pigatron-industries/xen_sequentialswitch/hardware/PGTN029_sequential_switch.brd

## EAGLE design hardware/PGTN029_sequential_switch.brd (2021-08-22)

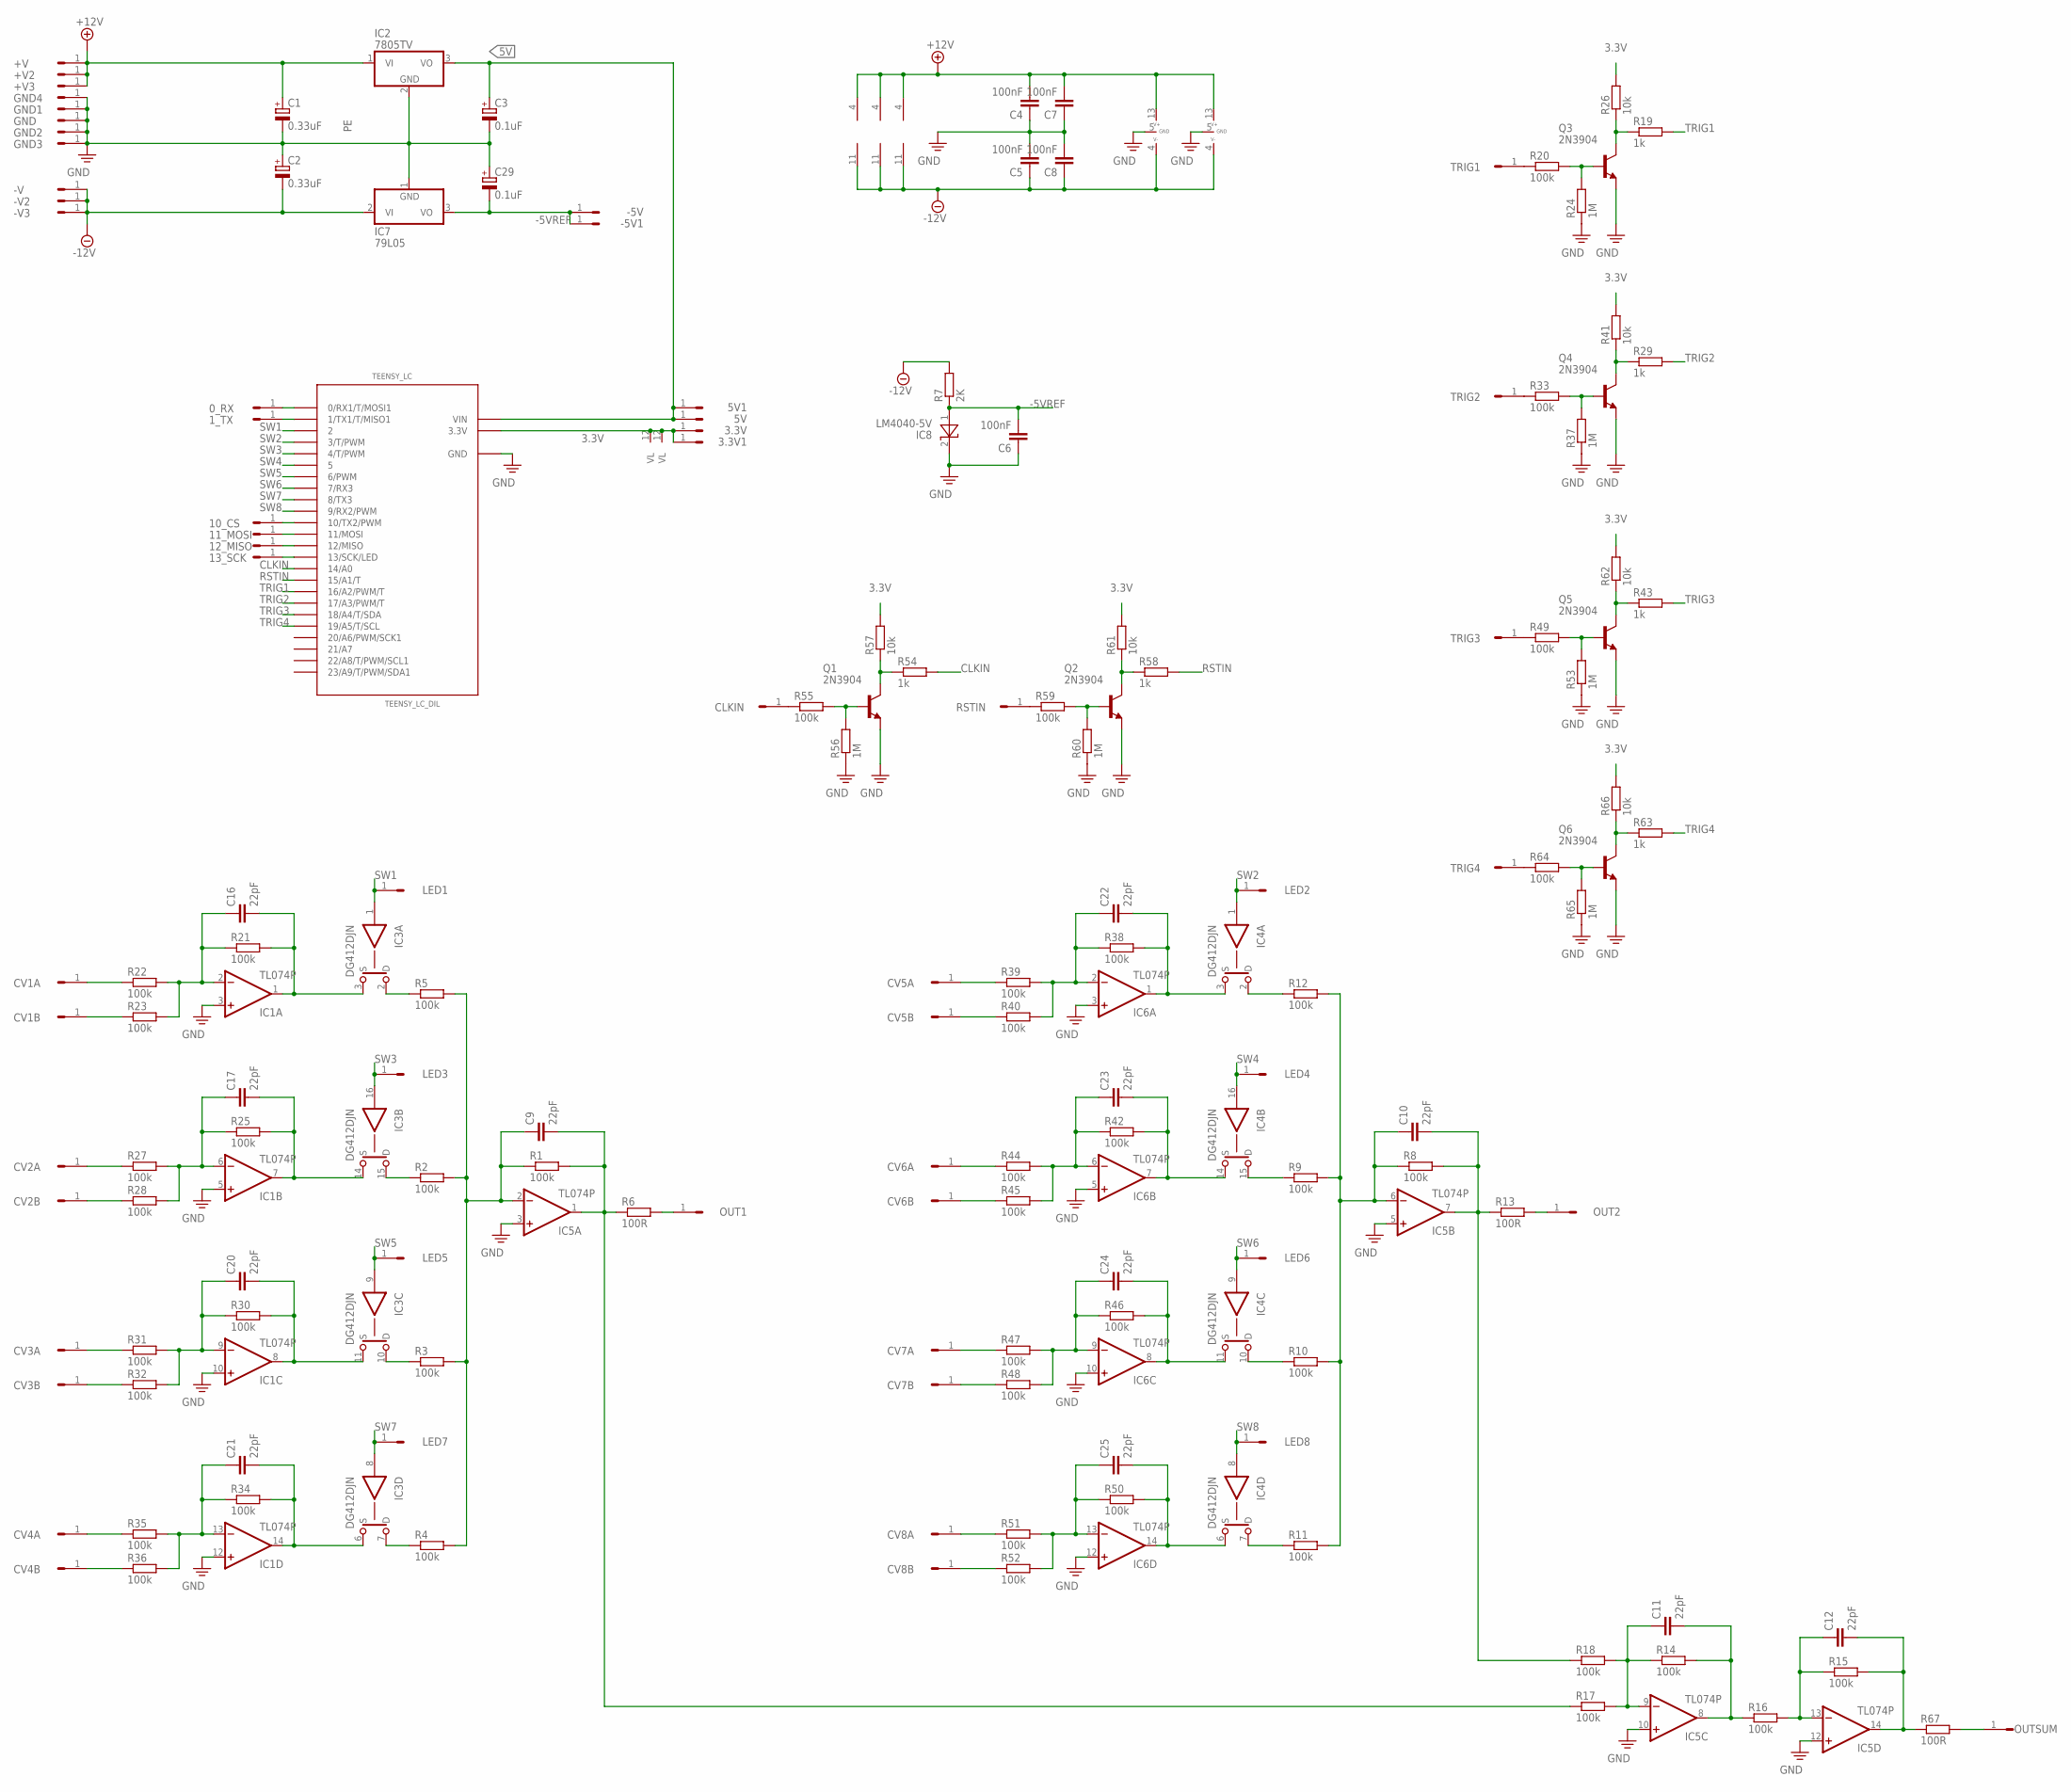
[picture p1: schematic PGTN029_sequential_switch.sch]

Parts:
0_RX, 1_TX, 3.3V, 3.3V1, 5V, 5V1, 10_CS, 11_MOSI, 12_MISO, 13_SCK: HEADER/MALE/01
+V, +V2, +V3: HEADER/MALE/01
-5V, -5V1: HEADER/MALE/01
-V, -V2, -V3: HEADER/MALE/01
C1, C2: 0.33uF; E2,5-6
C3, C29: 0.1uF; E2,5-6
C4, C5, C6, C7, C8: 100nF; CERAMICDISC/5
C9, C10, C11, C12, C16, C17, C20, C21, C22, C23, C24, C25: 22pF; CERAMICDISC/5
CLKIN: HEADER/MALE/01
CV1A, CV1B, CV2A, CV2B, CV3A, CV3B, CV4A, CV4B, CV5A, CV5B, CV6A, CV6B, CV7A, CV7B, CV8A, CV8B: HEADER/MALE/01
GND, GND1, GND2, GND3, GND4: HEADER/MALE/01
IC1, IC5, IC6: TL074P; DIL14
IC2: 7805TV; TO220V
IC3, IC4: DG412DJN; DIL16
IC7: 79L05; TO92
IC8: LM4040-5V; TO92
LED1, LED2, LED3, LED4, LED5, LED6, LED7, LED8: HEADER/MALE/01
OUT1, OUT2: HEADER/MALE/01
OUTSUM: HEADER/MALE/01
Q1, Q2, Q3, Q4, Q5, Q6: 2N3904; TO92
R1, R2, R3, R4, R5, R8, R9, R10, R11, R12, R14, R15, R16, R17, R18, R20, R21, R22, R23, R25, R27, R28, R30, R31, R32, R33, R34, R35, R36, R38, R39, R40, R42, R44, R45, R46, R47, R48, R49, R50, R51, R52, R55, R59, R64: 100k; RESISTOR/7.5
R6, R13, R67: 100R; RESISTOR/7.5
R7: 2K; RESISTOR/7.5
R19, R29, R43, R54, R58, R63: 1k; RESISTOR/7.5
R24, R37, R53, R56, R60, R65: 1M; RESISTOR/7.5
R26, R41, R57, R61, R62, R66: 10k; RESISTOR/7.5
RSTIN: HEADER/MALE/01
TEENSY_LC: TEENSY_LC_DIL; TEENSY_3.0-3.2&LC_DIL
TRIG1, TRIG2, TRIG3, TRIG4: HEADER/MALE/01

Connections:
3.3V: 3.3V.1, 3.3V1.1, IC3.12 (VL), IC4.12 (VL), R26.2, R41.2, R57.2, R61.2, R62.2, R66.2, TEENSY_LC.3.3V
5V: 5V.1, 5V1.1, C3.+, IC2.3 (VO), TEENSY_LC.VIN
+12V: +V.1, +V2.1, +V3.1, C1.+, C4.2, C7.2, IC1.4 (V+), IC2.1 (VI), IC3.13 (V+), IC4.13 (V+), IC5.4 (V+), IC6.4 (V+)
-5VREF: -5V.1, -5V1.1, C6.2, C29.-, IC7.3 (VO), IC8.1 (A), R7.1
-12V: -V.1, -V2.1, -V3.1, C2.-, C5.1, C8.1, IC1.11 (V-), IC3.4 (V-), IC4.4 (V-), IC5.11 (V-), IC6.11 (V-), IC7.2 (VI), R7.2
ADC0: C16.2, IC1.1 (OUT), IC3.3 (S), R21.2
ADC1: C17.2, IC1.7 (OUT), IC3.14 (S), R25.2
ADC2: C20.2, IC1.8 (OUT), IC3.11 (S), R30.2
ADC3: C21.2, IC1.14 (OUT), IC3.6 (S), R34.2
ADC4: C22.2, IC4.3 (S), IC6.1 (OUT), R38.2
ADC5: C23.2, IC4.14 (S), IC6.7 (OUT), R42.2
ADC6: C24.2, IC4.11 (S), IC6.8 (OUT), R46.2
ADC7: C25.2, IC4.6 (S), IC6.14 (OUT), R50.2
CLKIN: R54.2, TEENSY_LC.14/A0
unnamed: CV2A.1, R27.1
unnamed: C9.1, IC5.2 (-IN), R1.1, R2.2, R3.2, R4.2, R5.2
unnamed: C9.2, IC5.1 (OUT), R1.2, R6.1, R17.1
unnamed: IC3.15 (D), R2.1
unnamed: IC3.2 (D), R5.1
unnamed: IC3.10 (D), R3.1
unnamed: IC3.7 (D), R4.1
unnamed: C10.1, IC5.6 (-IN), R8.1, R9.2, R10.2, R11.2, R12.2
unnamed: C10.2, IC5.7 (OUT), R8.2, R13.1, R18.1
unnamed: IC4.15 (D), R9.1
unnamed: IC4.2 (D), R12.1
unnamed: IC4.10 (D), R10.1
unnamed: IC4.7 (D), R11.1
unnamed: OUT1.1, R6.2
unnamed: OUT2.1, R13.2
unnamed: C11.2, IC5.8 (OUT), R14.2, R16.1
unnamed: C11.1, IC5.9 (-IN), R14.1, R17.2, R18.2
unnamed: C12.2, IC5.14 (OUT), R15.2, R67.1
unnamed: C12.1, IC5.13 (-IN), R15.1, R16.2
unnamed: R20.1, TRIG1.1
unnamed: Q3.2 (B), R20.2, R24.2
unnamed: CV1A.1, R22.1
unnamed: Q3.1 (C), R19.1, R26.1
unnamed: C16.1, IC1.2 (-IN), R21.1, R22.2, R23.2
unnamed: R59.1, RSTIN.1
unnamed: CV2B.1, R28.1
unnamed: CV1B.1, R23.1
unnamed: OUTSUM.1, R67.2
unnamed: C17.1, IC1.6 (-IN), R25.1, R27.2, R28.2
unnamed: C21.1, IC1.13 (-IN), R34.1, R35.2, R36.2
unnamed: CV4A.1, R35.1
unnamed: CV4B.1, R36.1
unnamed: R33.1, TRIG2.1
unnamed: CV3B.1, R32.1
unnamed: CV3A.1, R31.1
unnamed: C20.1, IC1.9 (-IN), R30.1, R31.2, R32.2
unnamed: 12_MISO.1, TEENSY_LC.12 (12/MISO)
unnamed: C22.1, IC6.2 (-IN), R38.1, R39.2, R40.2
unnamed: 0_RX.1, TEENSY_LC.0 (0/RX1/T/MOSI1)
unnamed: CV5B.1, R40.1
unnamed: CV5A.1, R39.1
unnamed: 1_TX.1, TEENSY_LC.1 (1/TX1/T/MISO1)
unnamed: C23.1, IC6.6 (-IN), R42.1, R44.2, R45.2
unnamed: CV6A.1, R44.1
unnamed: CV6B.1, R45.1
unnamed: C25.1, IC6.13 (-IN), R50.1, R51.2, R52.2
unnamed: Q4.2 (B), R33.2, R37.2
unnamed: CV8A.1, R51.1
unnamed: CV8B.1, R52.1
unnamed: CV7B.1, R48.1
unnamed: CV7A.1, R47.1
unnamed: C24.1, IC6.9 (-IN), R46.1, R47.2, R48.2
unnamed: Q4.1 (C), R29.1, R41.1
unnamed: CLKIN.1, R55.1
unnamed: Q1.2 (B), R55.2, R56.2
unnamed: Q1.1 (C), R54.1, R57.1
unnamed: Q2.2 (B), R59.2, R60.2
unnamed: Q2.1 (C), R58.1, R61.1
unnamed: R49.1, TRIG3.1
unnamed: Q5.2 (B), R49.2, R53.2
unnamed: 10_CS.1, TEENSY_LC.10 (10/TX2/PWM)
unnamed: 11_MOSI.1, TEENSY_LC.11 (11/MOSI)
unnamed: 13_SCK.1, TEENSY_LC.13 (13/SCK/LED)
unnamed: Q5.1 (C), R43.1, R62.1
unnamed: R64.1, TRIG4.1
unnamed: Q6.2 (B), R64.2, R65.2
unnamed: Q6.1 (C), R63.1, R66.1
PE: C1.-, C2.+, C3.-, C4.1, C5.2, C6.1, C7.1, C8.2, C29.+, GND.1, GND1.1, GND2.1, GND3.1, GND4.1, IC1.3 (+IN), IC1.5 (+IN), IC1.10 (+IN), IC1.12 (+IN), IC2.2 (GND), IC3.5 (GND), IC4.5 (GND), IC5.3 (+IN), IC5.5 (+IN), IC5.10 (+IN), IC5.12 (+IN), IC6.3 (+IN), IC6.5 (+IN), IC6.10 (+IN), IC6.12 (+IN), IC7.1 (GND), IC8.2 (C), Q1.3 (E), Q2.3 (E), Q3.3 (E), Q4.3 (E), Q5.3 (E), Q6.3 (E), R24.1, R37.1, R53.1, R56.1, R60.1, R65.1, TEENSY_LC.AGND (GND), TEENSY_LC.GND
RSTIN: R58.2, TEENSY_LC.15/A1 (15/A1/T)
SW1: IC3.1 (IN), LED1.1, TEENSY_LC.2
SW2: IC4.1 (IN), LED2.1, TEENSY_LC.3 (3/T/PWM)
SW3: IC3.16 (IN), LED3.1, TEENSY_LC.4 (4/T/PWM)
SW4: IC4.16 (IN), LED4.1, TEENSY_LC.5
SW5: IC3.9 (IN), LED5.1, TEENSY_LC.6 (6/PWM)
SW6: IC4.9 (IN), LED6.1, TEENSY_LC.7 (7/RX3)
SW7: IC3.8 (IN), LED7.1, TEENSY_LC.8 (8/TX3)
SW8: IC4.8 (IN), LED8.1, TEENSY_LC.9 (9/RX2/PWM)
TRIG1: R19.2, TEENSY_LC.16/A2 (16/A2/PWM/T)
TRIG2: R29.2, TEENSY_LC.17/A3 (17/A3/PWM/T)
TRIG3: R43.2, TEENSY_LC.18/A4 (18/A4/T/SDA)
TRIG4: R63.2, TEENSY_LC.19/A5 (19/A5/T/SCL)

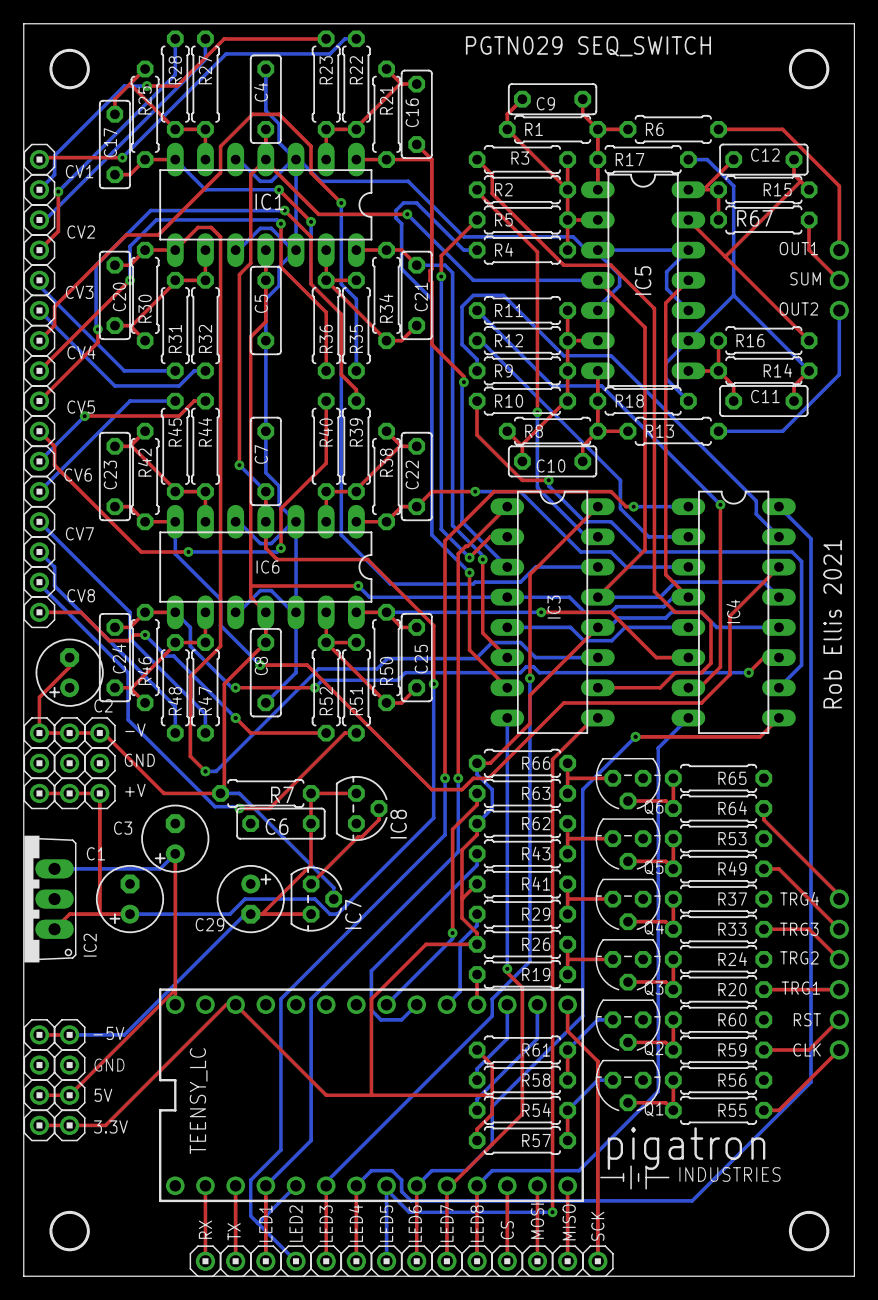
[picture p2: board PGTN029_sequential_switch.brd from above]

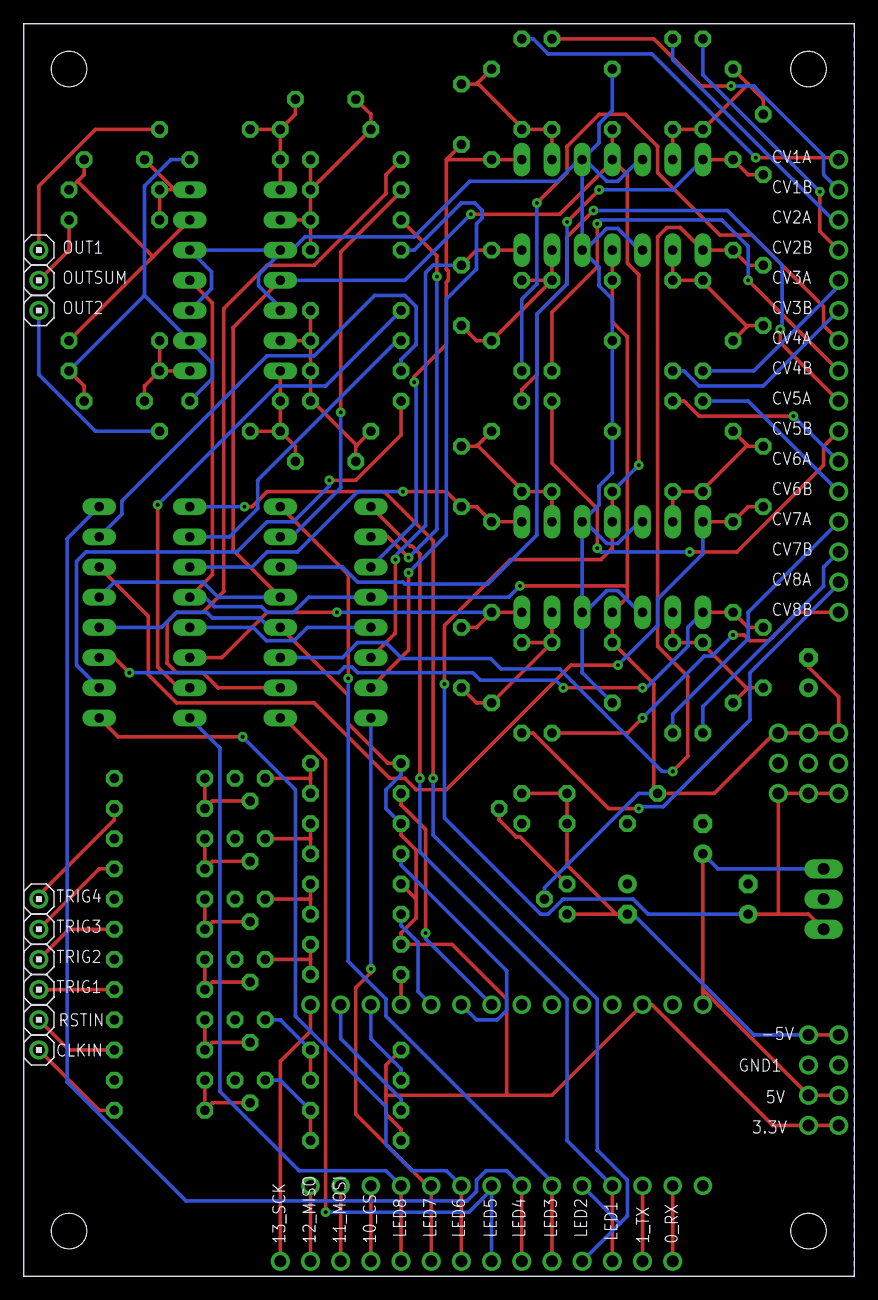
[picture p3: board PGTN029_sequential_switch.brd from below]

Board: 2 copper layers, 69.9 x 105.4 mm, 164 parts (9 on the bottom side), 95 nets.

Other parts of the board:
U$2, U$3, U$4, U$7: STANDOFF/3.0
U$5: PIGATRON-LOGO
